insidegadgets/LiPo-Battery-Gauge/Battery Gauge Main Board.brd

## EAGLE design Battery Gauge Main Board.brd (2019-11-12)

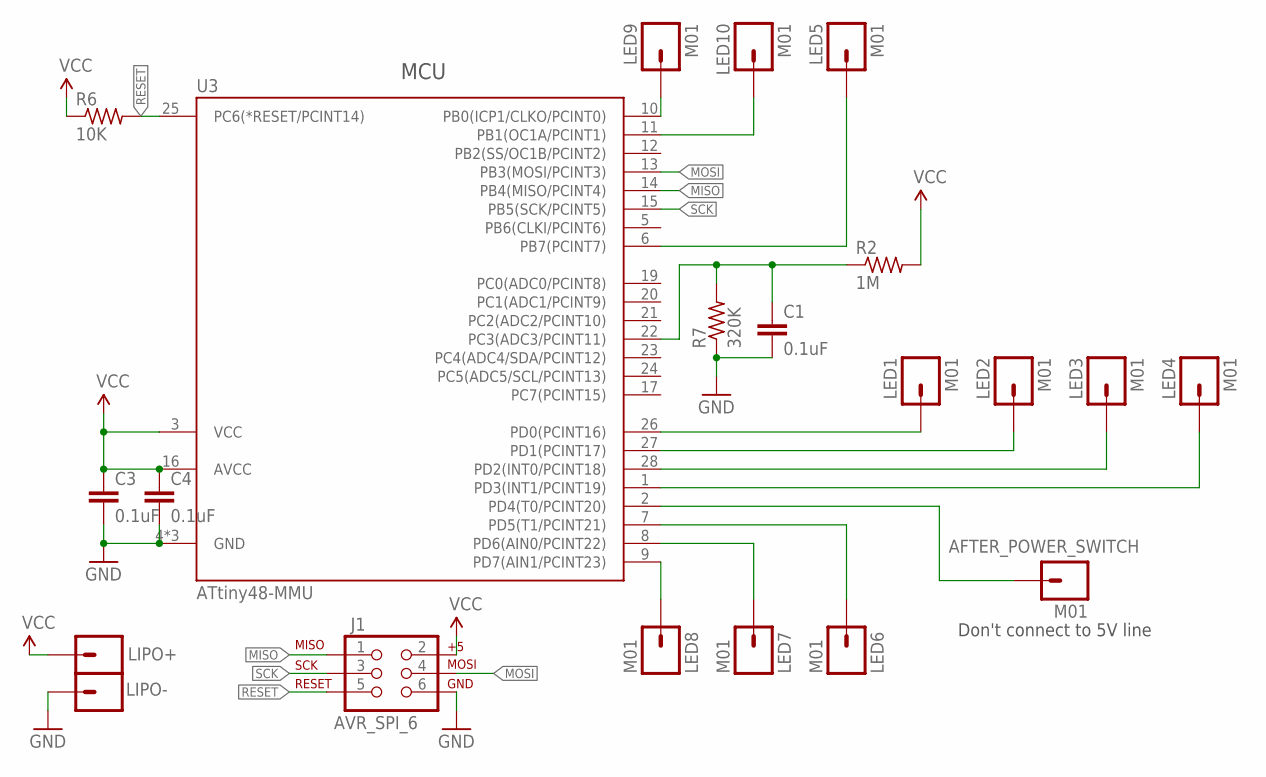
[picture p1: schematic Battery Gauge Main Board.sch]

Parts:
AFTER_POWER_SWITCH: M01; 1X01_SMD_SM
C1, C3, C4: 0.1uF; C0603K
J1: AVR_SPI_6; 2X3_2
LED1, LED2, LED3, LED4, LED5, LED6, LED7, LED8, LED9, LED10: M01; 1X01_SMD_SM
LIPO+: M01SMALL; 1X01_SMD_SMALL
LIPO-: M01SMALL; 1X01_SMD_SMALL
R2: 1M; R0603_S
R6: 10K; R0603_S
R7: 320K; R0603_S
U3: ATtiny48-MMU; VQFN-28

Connections:
GND: C1.2, C3.2, C4.2, J1.6, LIPO-.1, R7.1, U3.4 (GND), U3.18 (GND), U3.29 (GND)
MISO: J1.1, U3.14 (PB4(MISO/PCINT4))
MOSI: J1.4, U3.13 (PB3(MOSI/PCINT3))
unnamed: LED1.P$1, U3.26 (PD0(PCINT16))
unnamed: LED2.P$1, U3.27 (PD1(PCINT17))
unnamed: C1.1, R2.1, R7.2, U3.22 (PC3(ADC3/PCINT11))
unnamed: LED4.P$1, U3.1 (PD3(INT1/PCINT19))
unnamed: LED5.P$1, U3.6 (PB7(PCINT7))
unnamed: LED3.P$1, U3.28 (PD2(INT0/PCINT18))
unnamed: AFTER_POWER_SWITCH.P$1, U3.2 (PD4(T0/PCINT20))
unnamed: LED9.P$1, U3.10 (PB0(ICP1/CLKO/PCINT0))
unnamed: LED10.P$1, U3.11 (PB1(OC1A/PCINT1))
unnamed: LED6.P$1, U3.7 (PD5(T1/PCINT21))
unnamed: LED7.P$1, U3.8 (PD6(AIN0/PCINT22))
unnamed: LED8.P$1, U3.9 (PD7(AIN1/PCINT23))
RESET: J1.5, R6.2, U3.25 (PC6(*RESET/PCINT14))
SCK: J1.3, U3.15 (PB5(SCK/PCINT5))
VCC: C3.1, C4.1, J1.2, LIPO+.1, R2.2, R6.1, U3.3 (VCC), U3.16 (AVCC)

Notes on the sheet:
MCU
Don't connect to 5V line

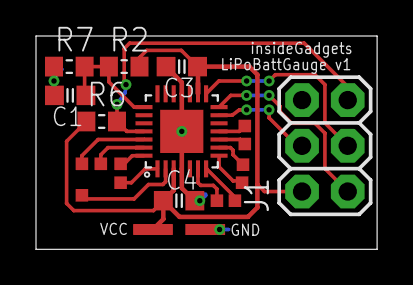
[picture p2: board Battery Gauge Main Board.brd from above]

Board: 2 copper layers, 18.9 x 11.9 mm, 21 parts (0 on the bottom side), 18 nets.
