insidegadgets/LiPo-Battery-Gauge/Battery Gauge LED Board.brd

## EAGLE design Battery Gauge LED Board.brd (2019-10-13)

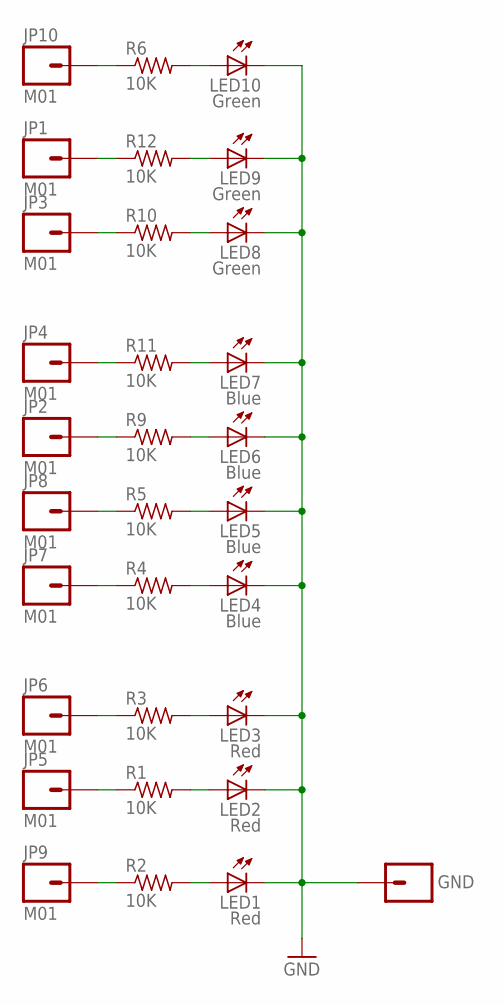
[picture p3: schematic Battery Gauge LED Board.sch]

Parts:
GND: M01; 1X01_SMD_SM
JP1, JP2, JP3, JP4, JP5, JP6, JP7, JP8, JP9, JP10: M01; 1X01_SMD_SM
LED1, LED2, LED3: Red; CHIPLED_1206_SLIM
LED4, LED5, LED6, LED7: Blue; CHIPLED_1206_SLIM
LED8, LED9, LED10: Green; CHIPLED_1206_SLIM
R1, R2, R3, R4, R5, R6, R9, R10, R11, R12: 10K; R0805_2

Connections:
GND: GND.P$1, LED1.C, LED2.C, LED3.C, LED4.C, LED5.C, LED6.C, LED7.C, LED8.C, LED9.C, LED10.C
unnamed: LED2.A, R1.2
unnamed: LED3.A, R3.2
unnamed: JP1.P$1, R12.1
unnamed: JP2.P$1, R9.1
unnamed: LED4.A, R4.2
unnamed: LED5.A, R5.2
unnamed: JP3.P$1, R10.1
unnamed: LED6.A, R9.2
unnamed: LED8.A, R10.2
unnamed: LED7.A, R11.2
unnamed: LED9.A, R12.2
unnamed: JP4.P$1, R11.1
unnamed: JP5.P$1, R1.1
unnamed: JP6.P$1, R3.1
unnamed: JP7.P$1, R4.1
unnamed: JP8.P$1, R5.1
unnamed: LED1.A, R2.2
unnamed: JP9.P$1, R2.1
unnamed: LED10.A, R6.2
unnamed: JP10.P$1, R6.1

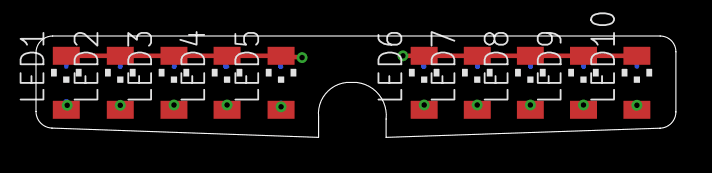
[picture p4: board Battery Gauge LED Board.brd from above]

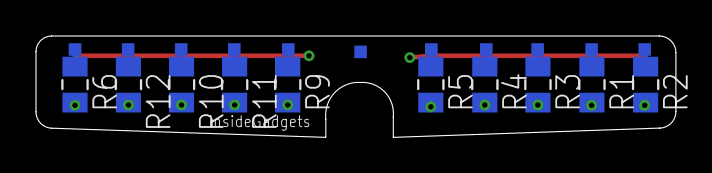
[picture p5: board Battery Gauge LED Board.brd from below]

Board: 2 copper layers, 35.5 x 5.6 mm, 31 parts (21 on the bottom side), 21 nets.
