insidegadgets/LiPo-Battery-Gauge/(commit log)

2019-10-13 Clean up, turn off LEDs at power on (as it sometimes happens at power off too)
2019-11-01 - Fixed interrupt bug - Used watchdog timer instead of delay for a ~1.5mA power saving
    [main.c, setup.c]
2019-11-01 Added power up animation
2019-11-12 Updated parts list
    [Battery Gauge Main Board.brd, Battery Gauge Main Board.sch]
